nanjin1/Intelligent-Delivery-Cart/README.md

# 2024 年广东省工科大学生实验综合技能竞赛

🏅获奖：广东省一等奖

### 🚩流程图：


根据比赛要求，我们需要在规定时间内准确地将物料送达目的地并返回起始区域。为了实现这一目标，我们采取了以下措施：

1. 路径规划：通过读取二维码模块返回的信息，主控芯片可以进行路径规划。二维码模块提供场地布局和目标位置等信息，使得机器人能够根据实时环境选择最优路径。路径规划算法可以考虑机器人的运动限制、避障策略以及最短路径等因素，以确保机器人能够高效地到达目标位置。
2. 物料装载检测：机器人舱内安装了红外传感器以确保物料被正确地装载到机器人上。
3. 姿态稳定控制：为了保持机器人在运行过程中的姿态稳定，陀螺仪被用作监控传感器来获取车身姿态信息。通过监测陀螺仪的状态，主控芯片可以生成相应的控制指令，例如调整电机转速或改变车轮转向，以维持机器人的姿态稳定。这样可以确保机器人在行驶过程中保持平衡，避免倾倒或失去控制。
4. 多传感器融合定位：为了确保机器人在场地中行走时的稳定性和安全性，我们团队在基于底层PID控制算法的基础上，增加了激光、超声波、红外等多种传感器。通过融合这些传感器的数据，我们能够准确地定位机器人的当前位置，并避免出现控制漂移的情况。
5. 打滑修正控制：为了减少机器人在场地上打滑的可能性，我们的传感器还参与决策打滑程度，并输出控制量来修正打滑对控制带来的误差。这样可以提高机器人的稳定性和控制精度。

### 🌟小车总体图：
