nanjin1/Intelligent-Delivery-Cart/(list of files, drawings)

Other design files:
智能配送c8t6-电路/c8t6.SchDoc
智能配送c8t6-电路/智能配送c8t6.PrjPcb
