nanjin1/Intelligent-Delivery-Cart/RCT6/Math/pid.c

#include "pid.h"
#include "uart.h"
//增量式PID
//带抗积分饱和
void incremental_PID (struct I_pid_obj *motor, struct PID_param *pid)
{
	float proportion = 0, integral = 0, differential = 0;
	
	motor->bias = motor->target - motor->measure;
	
	proportion = motor->bias - motor->last_bias;
	
	//抗积分饱和
	if (motor->output > pid->outputMax || motor->measure > pid->actualMax)
	{
		if (motor->bias < 0)
			integral = motor->bias;
	}
	else if (motor->output < -pid->outputMax || motor->measure < -pid->actualMax)
	{
		if (motor->bias > 0)
			integral = motor->bias;
	}
	else
	{
		integral = motor->bias;
	}
	
	differential = (motor->bias - 2 * motor->last_bias + motor->last2_bias);
	
	motor->output += pid->kp*proportion + pid->ki*integral + pid->kd*differential;
	
	motor->last2_bias = motor->last_bias;
	motor->last_bias = motor->bias;
}

//位置式PID
//带抗积分饱和
//带微分项低通滤波
float positional_PID (struct P_pid_obj *obj, struct PID_param *pid)
{
	float differential = 0;
	
	
	obj->bias = obj->target - obj->measure;
	
//	if(obj->bias <= 0.5f)return 0; //加一个死区
	
	if (obj->output >= pid->outputMax)
	{
		if (obj->bias < 0)
			obj->integral += obj->bias;
	}
	else if (obj->output <= pid->outputMin)
	{
		if (obj->bias > 0)
			obj->integral += obj->bias;
	}
	else
	{
		obj->integral += obj->bias;
	}
	
	//微分项低通滤波
	differential = (obj->bias - obj->last_bias) * pid->differential_filterK + 
					(1 - pid->differential_filterK) * obj->last_differential;
	
	obj->output = pid->kp * obj->bias + pid->ki * obj->integral + pid->kd * differential;
	
	obj->last_bias = obj->bias;
	obj->last_differential = differential;
	
	return obj->output;
}
