nanjin1/Intelligent-Delivery-Cart/RCT6/applications/speed_ctrl.c

#include "speed_ctrl.h"
#include "motor_task.h"
#include "pid.h"
#define need_gradual_cal 0
volatile struct Motors motor_all = {
	.Lspeed = 0,
	.Rspeed = 0,
	.GyroG_speedMax = 800,
	.GyroT_speedMax = 800,
	.SPEED_MAX = 300,
	.Diretion = 0,
	
	.Cincrement = 150,	//循迹加速度
	.Gincrement = 150,		//非循迹加速度
	.F_encoder_avg = 0,
	.R_encoder_avg = 0,
	.F_Distance = 0,
	.R_Distance = 0,
	
	.is_UP = false,
	.is_DOWM = false,
};
//TC_speed:巡线速度       TG_speed : 自平衡速度
struct Gradual TC_speed = {0,0,0},TG_speed = {0,0,0},CG_speed = {0,0,0};


void CarBrake(void)
{
	pid_mode_switch(is_No);
	motor_L0.target = 0;
	motor_R0.target = 0;
	motor_L1.target = 0;
	motor_R1.target = 0;
	motor_pid_clear();
}

//以一次函数缓慢加速或者缓慢停止
//形参 ：速度句柄  目标速度  加速度
void gradual_cal(struct Gradual *gradual, float target, float increment)  
{
	#if need_gradual_cal
	uint8_t direction = 0;
	
	if(target - gradual->Now < 0) 
		direction = 0;			//反向加速 
	else
		direction = 1;			//正向加速
		
	if(gradual->Now != target)	
	{
		if (direction)     
			gradual->Now += increment;
		else							
			gradual->Now -= increment;
	}
	else 
	{	
		return;				//达到目标速度
	}
	
	//超速处理
	if(direction == 1)
	{
		if(gradual->Now > target) 		
		{
			gradual->Now = target;
		}
	}
	else if(direction == 0)			
	{
		if(gradual->Now < target)
		{
			gradual->Now = target;
		}
	}
	#else
		gradual->Now = target;
	#endif
}
