nanjin1/Intelligent-Delivery-Cart/C8T6/C8T6/Driver/lcd.c

#include "lcd.h"
/******************************************************************************
      函数说明：显示图片
      入口数据：x,y起点坐标
                length 图片长度
                width  图片宽度
                pic[]  图片数组    
      返回值：  无
******************************************************************************/
void LCD_ShowPicture(u16 x,u16 y,u16 length,u16 width,const u8 pic[])
{
	u16 i,j;
	u32 k=0;
	LCD_Address_Set(x,y,x+length-1,y+width-1);
	for(i=0;i<length;i++)
	{
		for(j=0;j<width;j++)
		{
			LCD_WR_DATA8(pic[k*2]);
			LCD_WR_DATA8(pic[k*2+1]);
			k++;
		}
	}			
}
/******************************************************************************
      函数说明：LCD串行数据写入函数
      入口数据：dat  要写入的串行数据
      返回值：  无
******************************************************************************/
void LCD_Writ_Bus(u8 dat) 
{	
	u8 i;
	LCD_CS_Clr();
	for(i=0;i<8;i++)
	{			  
		LCD_SCLK_Clr();
		if(dat&0x80)
		{
		   LCD_MOSI_Set();
		}
		else
		{
		   LCD_MOSI_Clr();
		}
		LCD_SCLK_Set();
		dat<<=1;
	}	
  LCD_CS_Set();	
}
/******************************************************************************
      函数说明：LCD写入命令
      入口数据：dat 写入的命令
      返回值：  无
******************************************************************************/
void LCD_WR_REG(u8 dat)
{
	LCD_DC_Clr();//写命令
	LCD_Writ_Bus(dat);
	LCD_DC_Set();//写数据
}
/******************************************************************************
      函数说明：设置起始和结束地址
      入口数据：x1,x2 设置列的起始和结束地址
                y1,y2 设置行的起始和结束地址
      返回值：  无
******************************************************************************/
void LCD_Address_Set(u16 x1,u16 y1,u16 x2,u16 y2)
{
	if(USE_HORIZONTAL==0)
	{
		LCD_WR_REG(0x2a);//列地址设置
		LCD_WR_DATA(x1+2);
		LCD_WR_DATA(x2+2);
		LCD_WR_REG(0x2b);//行地址设置
		LCD_WR_DATA(y1+1);
		LCD_WR_DATA(y2+1);
		LCD_WR_REG(0x2c);//储存器写
	}
	else if(USE_HORIZONTAL==1)
	{
		LCD_WR_REG(0x2a);//列地址设置
		LCD_WR_DATA(x1+2);
		LCD_WR_DATA(x2+2);
		LCD_WR_REG(0x2b);//行地址设置
		LCD_WR_DATA(y1+1);
		LCD_WR_DATA(y2+1);
		LCD_WR_REG(0x2c);//储存器写
	}
	else if(USE_HORIZONTAL==2)
	{
		LCD_WR_REG(0x2a);//列地址设置
		LCD_WR_DATA(x1+1);
		LCD_WR_DATA(x2+1);
		LCD_WR_REG(0x2b);//行地址设置
		LCD_WR_DATA(y1+2);
		LCD_WR_DATA(y2+2);
		LCD_WR_REG(0x2c);//储存器写
	}
	else
	{
		LCD_WR_REG(0x2a);//列地址设置
		LCD_WR_DATA(x1+1);
		LCD_WR_DATA(x2+1);
		LCD_WR_REG(0x2b);//行地址设置
		LCD_WR_DATA(y1+2);
		LCD_WR_DATA(y2+2);
		LCD_WR_REG(0x2c);//储存器写
	}
}
/******************************************************************************
      函数说明：LCD写入数据
      入口数据：dat 写入的数据
      返回值：  无
******************************************************************************/
void LCD_WR_DATA8(u8 dat)
{
	LCD_Writ_Bus(dat);
}
/******************************************************************************
      函数说明：LCD写入数据
      入口数据：dat 写入的数据
      返回值：  无
******************************************************************************/
void LCD_WR_DATA(u16 dat)
{
	LCD_Writ_Bus(dat>>8);
	LCD_Writ_Bus(dat);
}

/******************************************************************************
      函数说明：在指定区域填充颜色
      入口数据：xsta,ysta   起始坐标
                xend,yend   终止坐标
								color       要填充的颜色
      返回值：  无
******************************************************************************/
void LCD_Fill(u16 xsta,u16 ysta,u16 xend,u16 yend,u16 color)
{          
	u16 i,j; 
	LCD_Address_Set(xsta,ysta,xend-1,yend-1);//设置显示范围
	for(i=ysta;i<yend;i++)
	{													   	 	
		for(j=xsta;j<xend;j++)
		{
			LCD_WR_DATA(color);
		}
	} 					  	    
}
void LCD_Init(void)
{
	LCD_RES_Clr();//复位
	HAL_Delay(100);
	LCD_RES_Set();
	HAL_Delay(100);
	
	LCD_BLK_Set();//打开背光
  HAL_Delay(100);
	
	//************* Start Initial Sequence **********//
	LCD_WR_REG(0x11); //Sleep out 
	HAL_Delay(120);              //Delay 120ms 
	//------------------------------------ST7735S Frame Rate-----------------------------------------// 
	LCD_WR_REG(0xB1); 
	LCD_WR_DATA8(0x05); 
	LCD_WR_DATA8(0x3C); 
	LCD_WR_DATA8(0x3C); 
	LCD_WR_REG(0xB2); 
	LCD_WR_DATA8(0x05);
	LCD_WR_DATA8(0x3C); 
	LCD_WR_DATA8(0x3C); 
	LCD_WR_REG(0xB3); 
	LCD_WR_DATA8(0x05); 
	LCD_WR_DATA8(0x3C); 
	LCD_WR_DATA8(0x3C); 
	LCD_WR_DATA8(0x05); 
	LCD_WR_DATA8(0x3C); 
	LCD_WR_DATA8(0x3C); 
	//------------------------------------End ST7735S Frame Rate---------------------------------// 
	LCD_WR_REG(0xB4); //Dot inversion 
	LCD_WR_DATA8(0x03); 
	//------------------------------------ST7735S Power Sequence---------------------------------// 
	LCD_WR_REG(0xC0); 
	LCD_WR_DATA8(0x28); 
	LCD_WR_DATA8(0x08); 
	LCD_WR_DATA8(0x04); 
	LCD_WR_REG(0xC1); 
	LCD_WR_DATA8(0XC0); 
	LCD_WR_REG(0xC2); 
	LCD_WR_DATA8(0x0D); 
	LCD_WR_DATA8(0x00); 
	LCD_WR_REG(0xC3); 
	LCD_WR_DATA8(0x8D); 
	LCD_WR_DATA8(0x2A); 
	LCD_WR_REG(0xC4); 
	LCD_WR_DATA8(0x8D); 
	LCD_WR_DATA8(0xEE); 
	//---------------------------------End ST7735S Power Sequence-------------------------------------// 
	LCD_WR_REG(0xC5); //VCOM 
	LCD_WR_DATA8(0x1A); 
	LCD_WR_REG(0x36); //MX, MY, RGB mode 
	if(USE_HORIZONTAL==0)LCD_WR_DATA8(0x00);
	else if(USE_HORIZONTAL==1)LCD_WR_DATA8(0xC0);
	else if(USE_HORIZONTAL==2)LCD_WR_DATA8(0x70);
	else LCD_WR_DATA8(0xA0); 
	//------------------------------------ST7735S Gamma Sequence---------------------------------// 
	LCD_WR_REG(0xE0); 
	LCD_WR_DATA8(0x04); 
	LCD_WR_DATA8(0x22); 
	LCD_WR_DATA8(0x07); 
	LCD_WR_DATA8(0x0A); 
	LCD_WR_DATA8(0x2E); 
	LCD_WR_DATA8(0x30); 
	LCD_WR_DATA8(0x25); 
	LCD_WR_DATA8(0x2A); 
	LCD_WR_DATA8(0x28); 
	LCD_WR_DATA8(0x26); 
	LCD_WR_DATA8(0x2E); 
	LCD_WR_DATA8(0x3A); 
	LCD_WR_DATA8(0x00); 
	LCD_WR_DATA8(0x01); 
	LCD_WR_DATA8(0x03); 
	LCD_WR_DATA8(0x13); 
	LCD_WR_REG(0xE1); 
	LCD_WR_DATA8(0x04); 
	LCD_WR_DATA8(0x16); 
	LCD_WR_DATA8(0x06); 
	LCD_WR_DATA8(0x0D); 
	LCD_WR_DATA8(0x2D); 
	LCD_WR_DATA8(0x26); 
	LCD_WR_DATA8(0x23); 
	LCD_WR_DATA8(0x27); 
	LCD_WR_DATA8(0x27); 
	LCD_WR_DATA8(0x25); 
	LCD_WR_DATA8(0x2D); 
	LCD_WR_DATA8(0x3B); 
	LCD_WR_DATA8(0x00); 
	LCD_WR_DATA8(0x01); 
	LCD_WR_DATA8(0x04); 
	LCD_WR_DATA8(0x13); 
	//------------------------------------End ST7735S Gamma Sequence-----------------------------// 
	LCD_WR_REG(0x3A); //65k mode 
	LCD_WR_DATA8(0x05); 
	LCD_WR_REG(0x29); //Display on 
}
