nanjin1/Intelligent-Delivery-Cart/C8T6/C8T6/Driver/lcd.h

#ifndef __LCD_H__
#define __LCD_H__
#include "main.h"
#include "gpio.h"
#define USE_HORIZONTAL 3  //设置横屏或者竖屏显示 0或1为竖屏 2或3为横屏

#if USE_HORIZONTAL==0||USE_HORIZONTAL==1
#define LCD_W 128
#define LCD_H 160

#else
#define LCD_W 160
#define LCD_H 128
#endif

//-----------------LCD端口定义---------------- 

#define LCD_SCLK_Clr() HAL_GPIO_WritePin(GPIOB,GPIO_PIN_9,GPIO_PIN_RESET)//SCL=SCLK
#define LCD_SCLK_Set() HAL_GPIO_WritePin(GPIOB,GPIO_PIN_9,GPIO_PIN_SET)

#define LCD_MOSI_Clr() HAL_GPIO_WritePin(GPIOB,GPIO_PIN_8,GPIO_PIN_RESET)//SDA=MOSI
#define LCD_MOSI_Set() HAL_GPIO_WritePin(GPIOB,GPIO_PIN_8,GPIO_PIN_SET)

#define LCD_RES_Clr()  HAL_GPIO_WritePin(GPIOB,GPIO_PIN_5,GPIO_PIN_RESET)//RES
#define LCD_RES_Set()  HAL_GPIO_WritePin(GPIOB,GPIO_PIN_5,GPIO_PIN_SET)

#define LCD_DC_Clr()   HAL_GPIO_WritePin(GPIOB,GPIO_PIN_4,GPIO_PIN_RESET)//DC
#define LCD_DC_Set()   HAL_GPIO_WritePin(GPIOB,GPIO_PIN_4,GPIO_PIN_SET)
 		     
#define LCD_CS_Clr()   HAL_GPIO_WritePin(GPIOB,GPIO_PIN_3,GPIO_PIN_RESET)//CS
#define LCD_CS_Set()   HAL_GPIO_WritePin(GPIOB,GPIO_PIN_3,GPIO_PIN_SET)

#define LCD_BLK_Clr()  HAL_GPIO_WritePin(GPIOA,GPIO_PIN_15,GPIO_PIN_RESET)//BLK
#define LCD_BLK_Set()  HAL_GPIO_WritePin(GPIOA,GPIO_PIN_15,GPIO_PIN_SET)

//画笔颜色
#define WHITE         	 0xFFFF
#define BLACK         	 0x0000	  
#define BLUE           	 0x001F  
#define BRED             0XF81F
#define GRED 			       0XFFE0
#define GBLUE			       0X07FF
#define RED           	 0xF800
#define MAGENTA       	 0xF81F
#define GREEN         	 0x07E0
#define CYAN          	 0x7FFF
#define YELLOW        	 0xFFE0
#define BROWN 			     0XBC40 //棕色
#define BRRED 			     0XFC07 //棕红色
#define GRAY  			     0X8430 //灰色
#define DARKBLUE      	 0X01CF	//深蓝色
#define LIGHTBLUE      	 0X7D7C	//浅蓝色  
#define GRAYBLUE       	 0X5458 //灰蓝色
#define LIGHTGREEN     	 0X841F //浅绿色
#define LGRAY 			     0XC618 //浅灰色(PANNEL),窗体背景色
#define LGRAYBLUE        0XA651 //浅灰蓝色(中间层颜色)
#define LBBLUE           0X2B12 //浅棕蓝色(选择条目的反色)

typedef uint8_t u8;
typedef uint16_t u16;
typedef uint32_t  u32;

void LCD_Init(void);
void LCD_WR_DATA(u16 dat);
void LCD_Writ_Bus(u8 dat);
void LCD_WR_REG(u8 dat);
void LCD_Address_Set(u16 x1,u16 y1,u16 x2,u16 y2);
void LCD_WR_DATA8(u8 dat);
void LCD_Fill(u16 xsta,u16 ysta,u16 xend,u16 yend,u16 color);
void LCD_ShowPicture(u16 x,u16 y,u16 length,u16 width,const u8 pic[]);

#endif
