nanjin1/Intelligent-Delivery-Cart/C8T6/C8T6/Driver/pic.h

#ifndef __PIC_H__
#define __PIC_H__
#include "main.h"
#include "gpio.h"
extern const unsigned char gImage_meituan[40960];
extern const unsigned char gImage_1[36608];
extern const unsigned char gImage_2[36352];
#endif
