nanjin1/Intelligent-Delivery-Cart/RCT6/Driver/delay.c

#include "delay.h"
#include "encoder.h"
#include "motor.h"
#include "Start_task.h"
#define detect_dog 3
struct Time sys_time;
//延时函数+电机狗
TIM_HandleTypeDef TIM6_Handler;
void delay_init(void)
{
    //定时器7
    __HAL_RCC_TIM6_CLK_ENABLE();
     
    TIM6_Handler.Instance=TIM6;                          //通用定时器7
    TIM6_Handler.Init.Prescaler=72-1;                     //分频
    TIM6_Handler.Init.CounterMode=TIM_COUNTERMODE_UP;    //向上计数器
    TIM6_Handler.Init.Period=1500-1;                        //自动装载值
    TIM6_Handler.Init.ClockDivision=TIM_CLOCKDIVISION_DIV1;
    HAL_TIM_Base_Init(&TIM6_Handler);
	  HAL_NVIC_SetPriority(TIM6_IRQn,9,0);    //设置中断优先级，抢占优先级3，子优先级3
    HAL_NVIC_EnableIRQ(TIM6_IRQn);          //开启ITM4中断  
    HAL_TIM_Base_Start_IT(&TIM6_Handler); //使能定时器7和定时器7中断 
}

//1.5ms  
void TIM6_IRQHandler(void)
{
		static uint8_t mouse = 0;    //小灯鼠
		static uint8_t times = 0;
    if(__HAL_TIM_GET_IT_SOURCE(&TIM6_Handler,TIM_IT_UPDATE)==SET){//溢出中断
			sys_time.times++;
			if(times%2==0){
						for(uint8_t i=0;i<4;i++){
							dog[i]++;   //电机狗
							if(dog[i]>=detect_dog)
								high_time[i]=0;
							if(dog[i]>=255){
										dog[i]=0;   //电机狗
							}
						}					
						mouse++;
						if(mouse>100){
							mouse =0;
							LED_twinkle();
						}
						if(times>250){
							times = 0;
						}
				}
		}
    __HAL_TIM_CLEAR_IT(&TIM6_Handler, TIM_IT_UPDATE);//清除中断标志位
}

//最多延时1500us
void delay_us(uint16_t nus)
{
   TIM6->CNT = 0;
	 while(TIM6->CNT<nus);
}

void delay_ms(uint16_t nms)
{
	for(uint16_t i=0;i<nms;i++){
		delay_us(1000);
	}
}
