nanjin1/Intelligent-Delivery-Cart/(notices)

Notices in the files:
RCT6/USMAT/uart.h:
Copyright(C) ¹ãÖÝÊÐÐÇÒíµç×Ó¿Æ¼¼ÓÐÏÞ¹«Ë¾ 2009-2019
All rights reserved
C8T6/C8T6/Core/Src/main.c:
© Copyright (c) 2022 STMicroelectronics.
This software component is licensed by ST under BSD 3-Clause license,
the "License"; You may not use this file except in compliance with the
License. You may obtain a copy of the License at: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
(C) COPYRIGHT STMicroelectronics *****END OF FILE
